RAKWireless/RAK2270-Sticker-Tracker/Hardware/RAK2270-bareboard-1.jpg

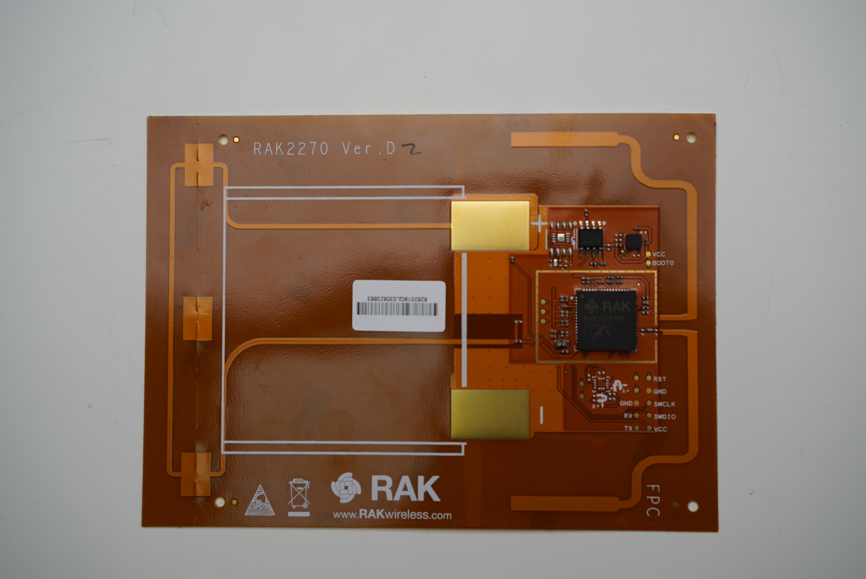
Hardware/RAK2270-bareboard-1.jpg
