RAKWireless/RAK2270-Sticker-Tracker/Hardware/pins_location.png

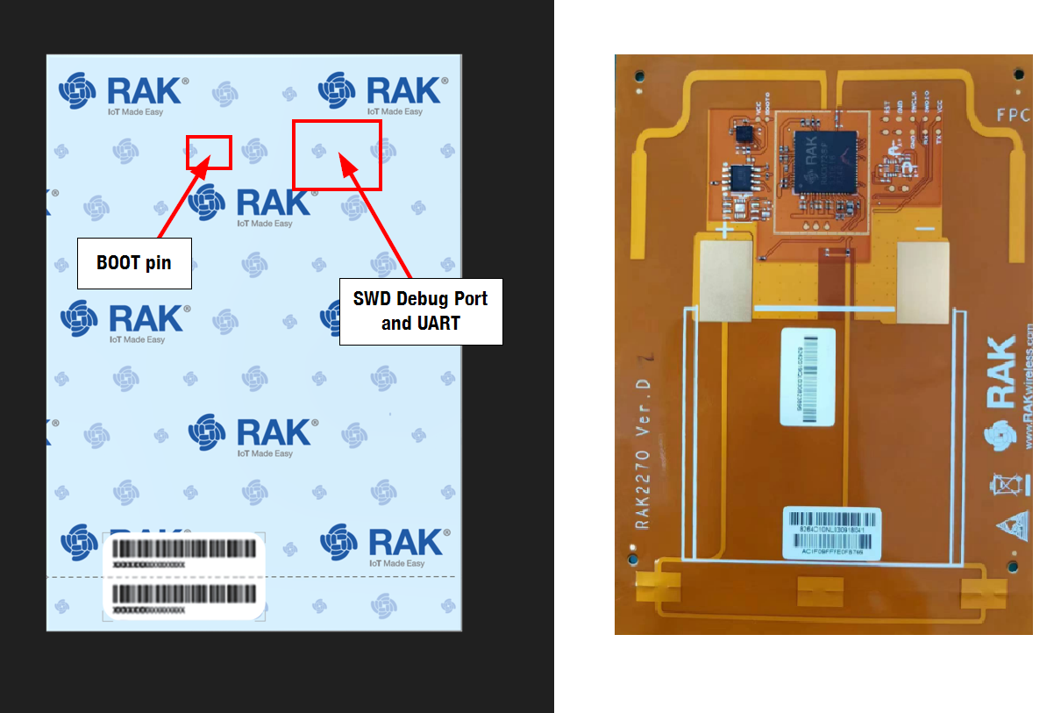
Hardware/pins_location.png
