RAKWireless/RAK2270-Sticker-Tracker/Hardware/RAK2270-sticker-2.png

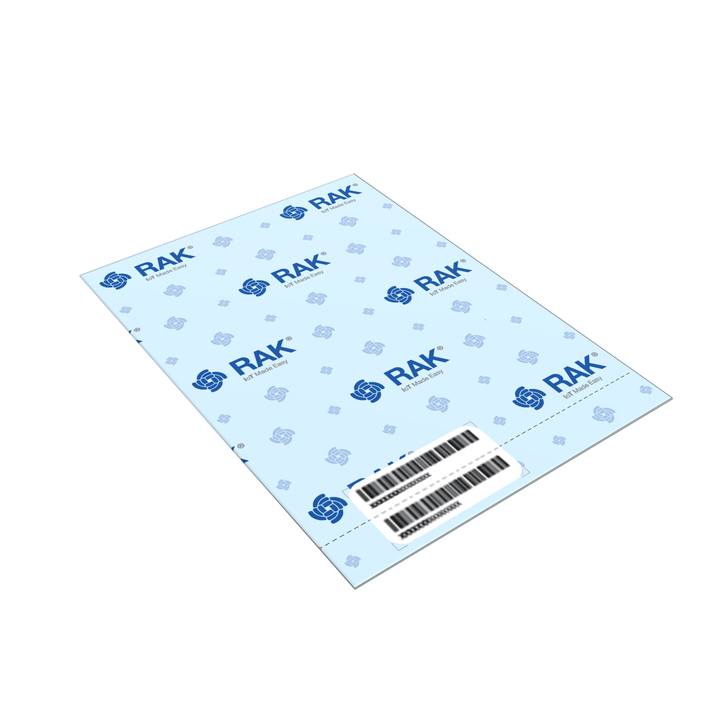
Hardware/RAK2270-sticker-2.png
