RAKWireless/RAK2270-Sticker-Tracker/Hardware/BOM of RAK2270(FPCB-WITHOUT EEPROM-OPENSOURCE).xls

RAK code | Quantity | Manufacturer | Part number | Description | Designator
0807A01A | 2 | YAGEO , 国巨股份有限公司 | CC0402MRX5R5BB475 | Capacitor-6.3V-4.7uF-±20%-X5R-0402 | C1,C7
08070009 | 8 | YAGEO , 国巨股份有限公司 | CC0402KRX5R9BB104 | Capacitor-50V-100nF-±10%-X5R-0402 | C2,C3,C8,C10,C11,C12,C16,C23
08070612 | 4 | MURATA , 村田制作所 | GRM155R61A105KE15D | Capacitor-10V-1uF-±10%-X5R-0402 | C4,C5,C6,C9
0807C001 | 1 | YAGEO , 国巨股份有限公司 | CC0402KRX5R9BB474 | Capacitor-50V-470nF-±10%-X5R-0402 | C15
08070561 | 2 | TDK , 东京电气化学株式会社 | C1005X5R1A104KT000F | Capacitor-10V-100nF-±10%-X5R -0402 | C17,C18
0807C002 | 1 | MURATA , 村田制作所 | GRM1555C1H560JA01D | Capacitor-50V-56pF-±5%-COG-0402 | C19
1007B006 | 3 | MURATA , 村田制作所 | BLM15PD121SN1B | EMI Ferrite Bead-120Ω-±25%@100MHz-0.09Ω-1.3A-0402 | E1,E2,E3
1003C00V | 1 | TDK , 东京电气化学株式会社 | MLZ2012M150WT000 | Inductor-15uH-±20%-0.95Ω±30%-250mA-0805 | L1
07090867 | 7 | YAGEO , 国巨股份有限公司 | RC0402FR-0710KL | Resistor-1/16W-10KΩ-±1％-0402 | R1,R2,R11,R15,R16,R23,R24
0705B001 | 1 | MURATA , 村田制作所 | NCP15XH103F03RC | NTC Thermistor-10KΩ ±1％-B(25-50℃) 3380K-0402 | R10
07090809 | 1 | YAGEO , 国巨股份有限公司 | RC0402JR-071KL | Resistor-1/16W-1KΩ-±5%-0402 | R25
4204C011 | 1 | RAK | RAK3172-SIP | IC MCU-RAK3172-SiP-32 bit Cortex M4-LoRa Transceiver-256KB Flash-64KB SRAM-QFN64-12*12mm | U1
07090793 | 2 | YAGEO , 国巨股份有限公司 | RC0402JR-074K7L | Resistor-1/16W-4.7KΩ-±5％-0402 | R20,R21
3301C002 | 1 | ST MICROELECTRONICS,意法半导体 | LIS3DH | Sensor-MEMS-Motion sensor-1.71~3.6V-LGA16-3*3*1mm | U2
8261010Y | 1 |  |  | FPCB-WisNode-Stick Sensor-RAK2270-2 Layer-Thickness 0.2mm-2x2 Panel-Panel Size 198*238mm-PCB Size 85*118mm
