RAKWireless/RAK2270-Sticker-Tracker/(threads)

Thread 3 (2023-11-07):

Arduino New IDE 2.x not finding Installation JSON

hpssjellis, 2023-11-07:
The new Arduino 2.x IDE is having troubles finding the installation STM32 boards. It loads the other RAKWireless boards but not the RUI ones. It seems to load the .JSON file fine but when we search for "RAK" it does not find the ```RAKwireless RUI STM32``` Boards. I am find since I can use the old Arduino IDE, just wondering if the new Arduino IDE works for anyone else.

```
https://raw.githubusercontent.com/RAKWireless/RAKwireless-Arduino-BSP-Index/main/package_rakwireless.com_rui_index.json
```

The Old Arduino IDE 1.8.x works fine, just search for ```RAK``` and the boards are found

carlrakwireless, 2023-11-08:
Hi @hpssjellis ,

It my setup, I see the RAK RUI3 based modules.

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

I do not use Arduino 2.x though as a still find legacy Arduino IDE faster/leaner to use.

hpssjellis, 2023-11-08:
Hey @carlrakwireless. Good to know it does works for someone. I have tried 3 Arduino IDE v2 with no luck even though the other RAKwireless .json file works fine.  I do have the old Arduino IDE on some of my computers so I should be fine. I will tag you on a few more issues. We can close this one.

Closed 2023-11-08.

Thread 4 (2023-11-08):

Which board is compatible to the RAK2270 is it WisDuo RAK3172 E or T

hpssjellis, 2023-11-08:
**Which board is compatible to the RAK2270 is it WisDuo RAK3172 E or T**

@carlrakwireless  Is the compatible board the WisDuo  RAK3172 Evaluation board or the WisDuo RAK3172 T Board

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

carlrakwireless, 2023-11-08:
It should be `WisDuo RAK3172-T Board`.

hpssjellis, 2023-11-08:
> It should be `WisDuo RAK3172-SiP Board`.

I agree, but that isn't one of the options in the image. The image shows the WisDuo RACK3**2**72-SiP board.

```
The main chip used on the RAK2270 is the WisDuo Module RAK3172-SiP/RAK3172LP-SiP (pin-to-pin and software compatible). This chip has STM32WL SoC which is a combination of MCU and LoRa/SubGhz transceiver. The firmware written on this is based on [RUI3](https://docs.rakwireless.com/RUI3/). You can start creating your own firmware using this [RAK3172-SiP guide](https://docs.rakwireless.com/Product-Categories/WisDuo/RAK3172-SiP/Quickstart/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).
```

carlrakwireless, 2023-11-08:
I see. You can choose `RAK3272-SiP Board`. It will work fine.

hpssjellis, 2023-11-08:
Sounds, good thanks.

Closed 2023-11-08.

Thread 5 (2023-11-08):

Example Acceleration code for the RAK2270

hpssjellis, 2023-11-08:
**Example Acceleration code for the RAK2270**

@carlrakwireless

Where would I find example Acceleration code for the RAK2270?

It looks like it is fairly simple I2C communication

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

carlrakwireless, 2023-11-08:
Hi @hpssjellis ,

The 3-axis accelerometer is based on RAK1904.

You can follow this guide for its basic functionality.

https://docs.rakwireless.com/Product-Categories/WisBlock/RAK1904/Quickstart/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

Closed 2023-11-08.

Thread 6 (2023-11-22):

Generic RAK2270 Firmware

hpssjellis, 2023-11-22:
Any chance a generic RAK2270 firmware with version number could be posted.

@carlrakwireless

It would be really interesting to see what compression method is used, how it is done and if the present firmware has any download read ability (To perhaps change the data upload rate etc.). Also to see how the temperature value is read and if the accelerometer is initiated (Probably not)

carlrakwireless, 2023-11-22:
I already replied in RAK forum. Closing.

Closed 2023-11-22.
