RAKWireless/RAK2270-Sticker-Tracker/Hardware/Schematic_RAK2270_VC_2023_0530.pdf

# Debug Interface

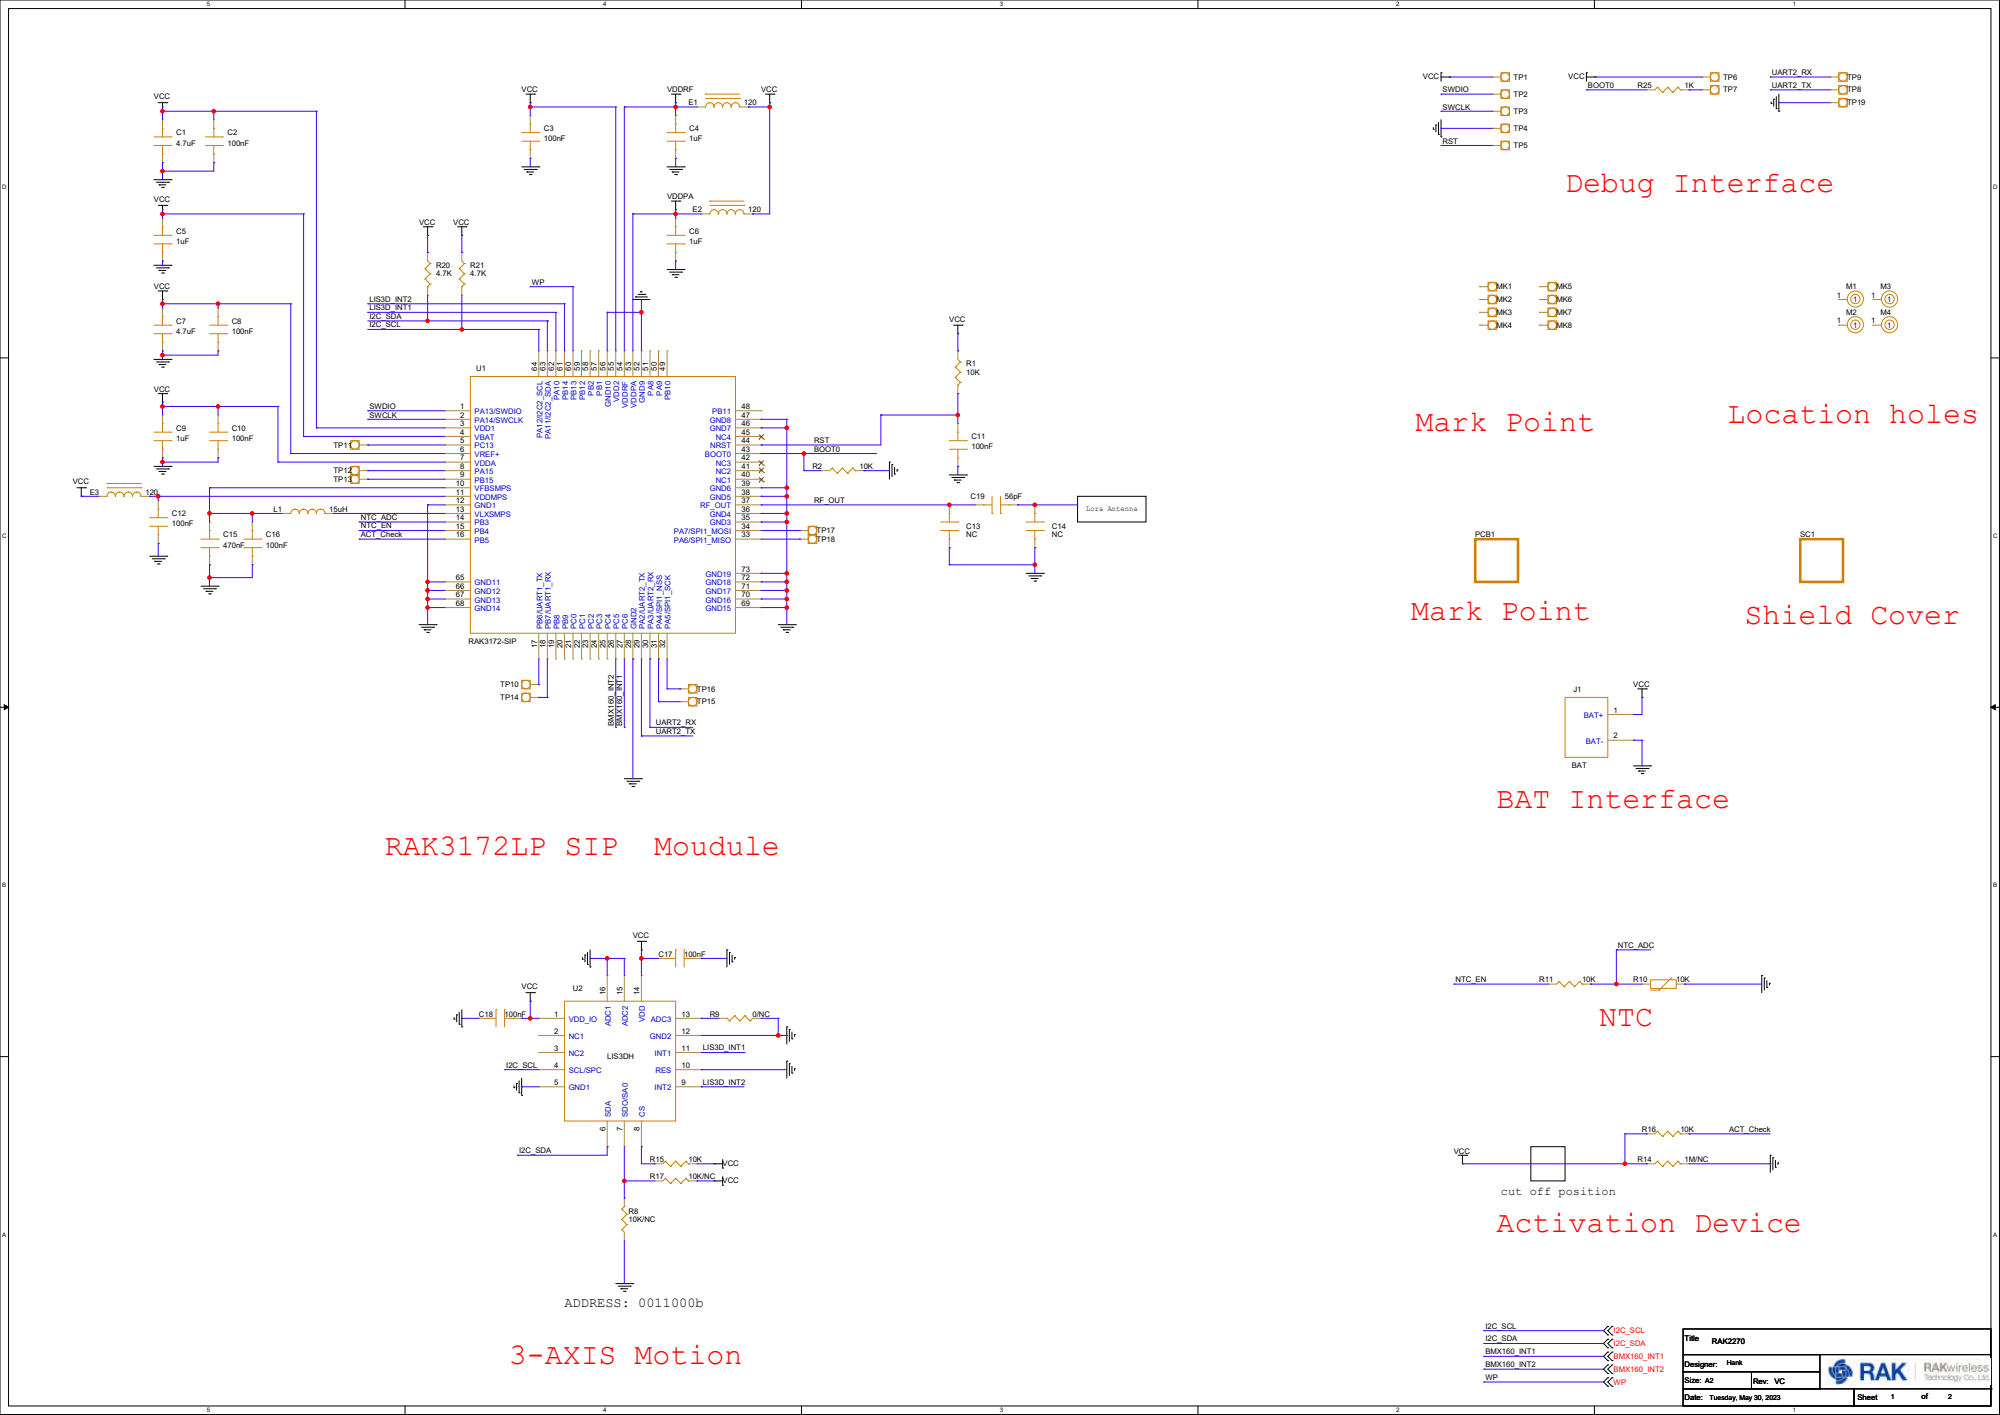
[picture p6: page 1]

SOIC-8 | ADDRESS: 1110000

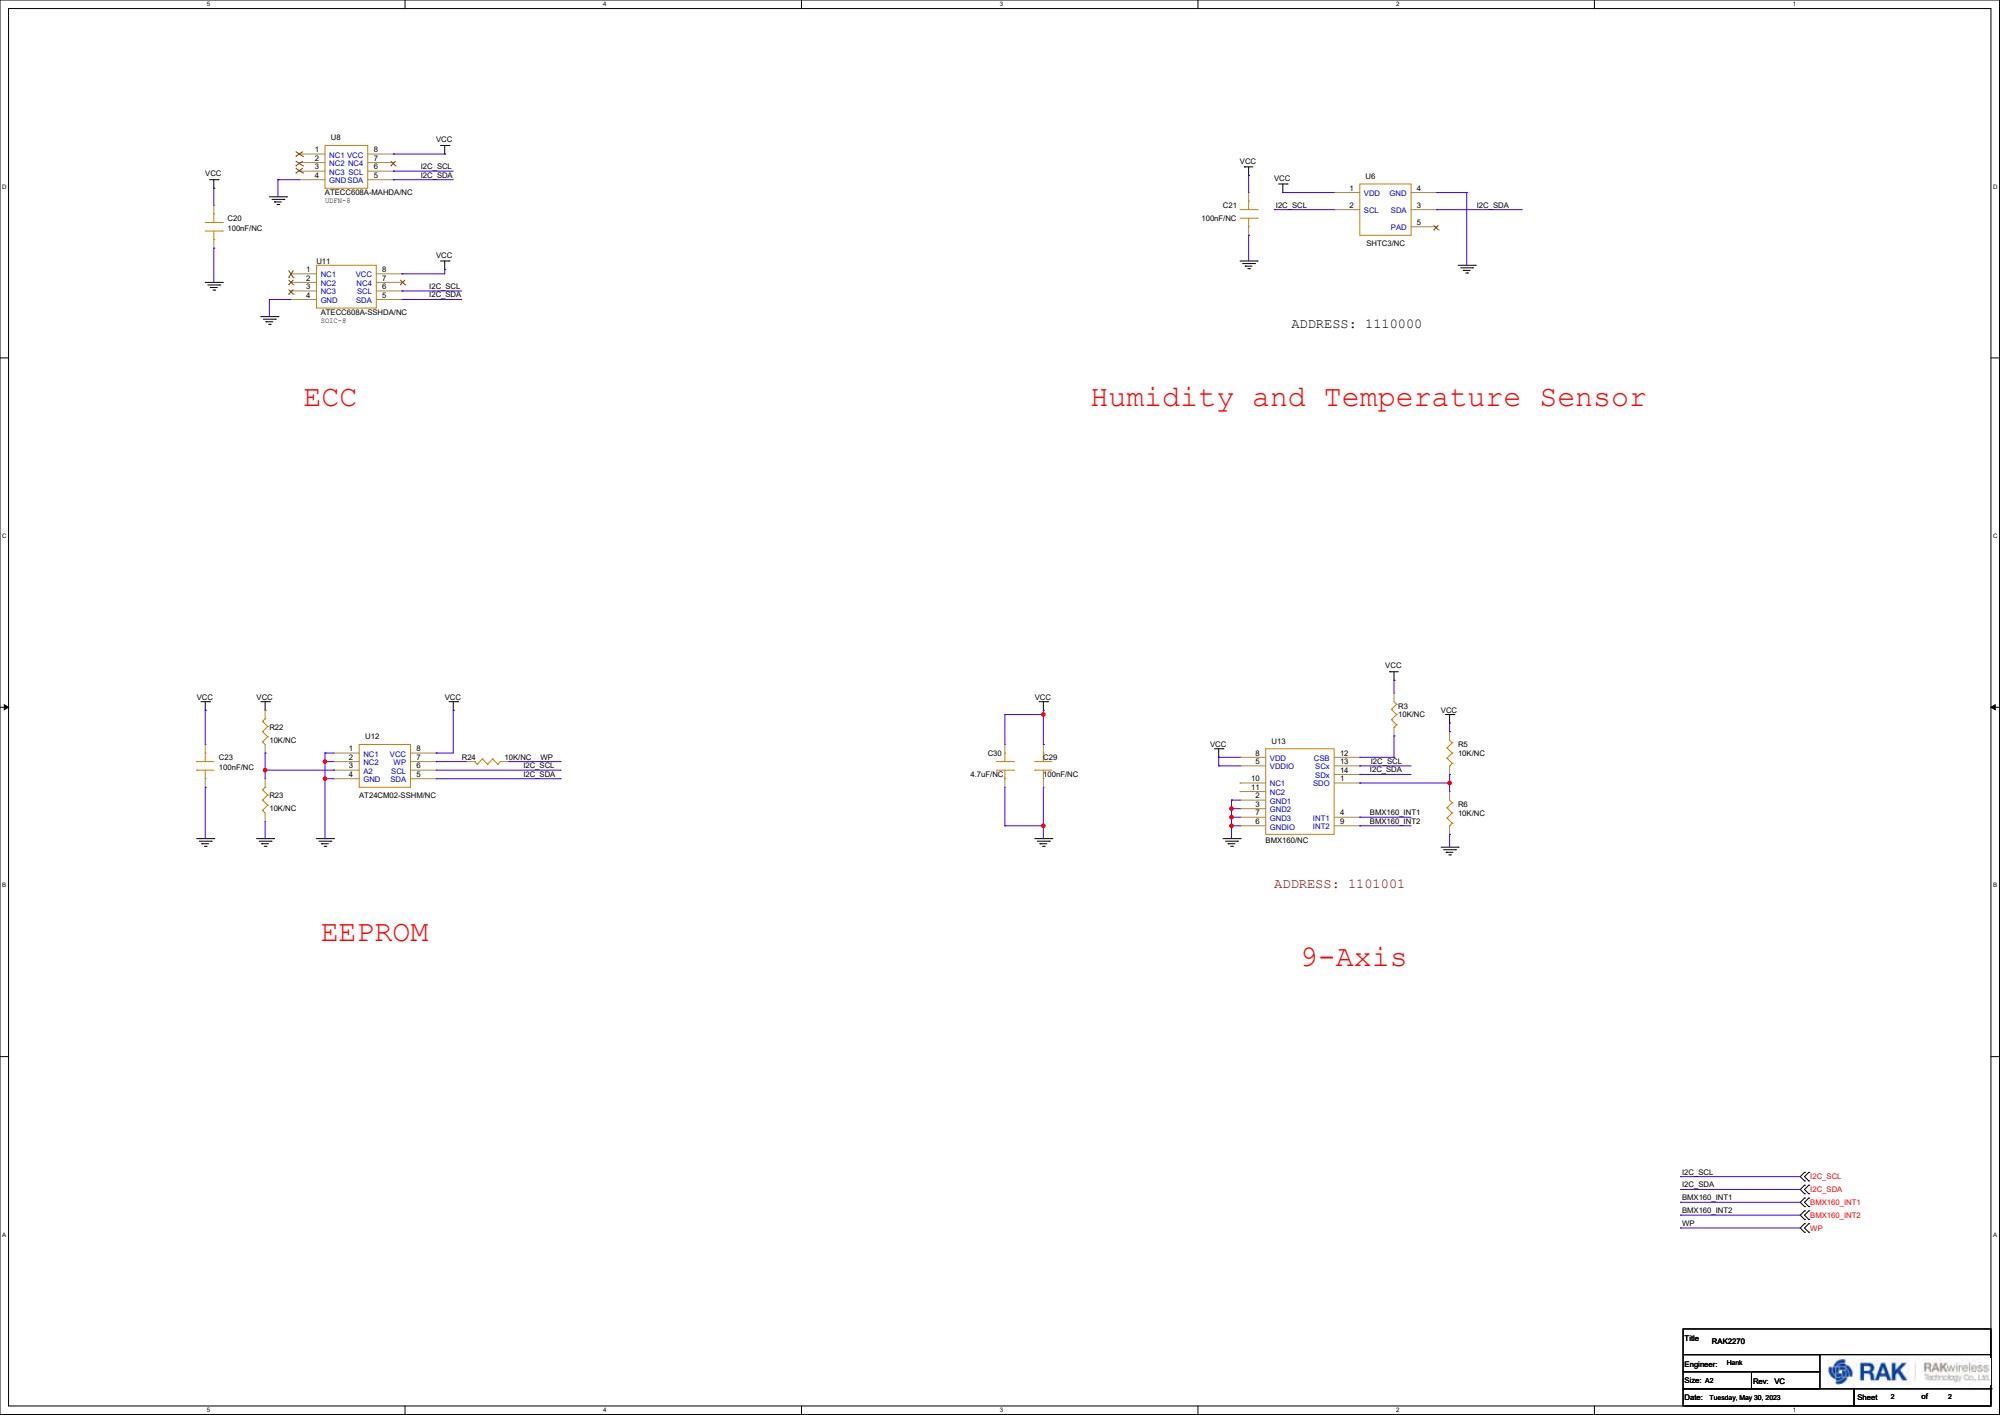
[picture p7: page 2]

Humidity and Temperature Sensor
