RAKWireless/RAK2270-Sticker-Tracker/Hardware/Testpoints_RAK2270_FPC_VC.pdf

# ART FILM - adt

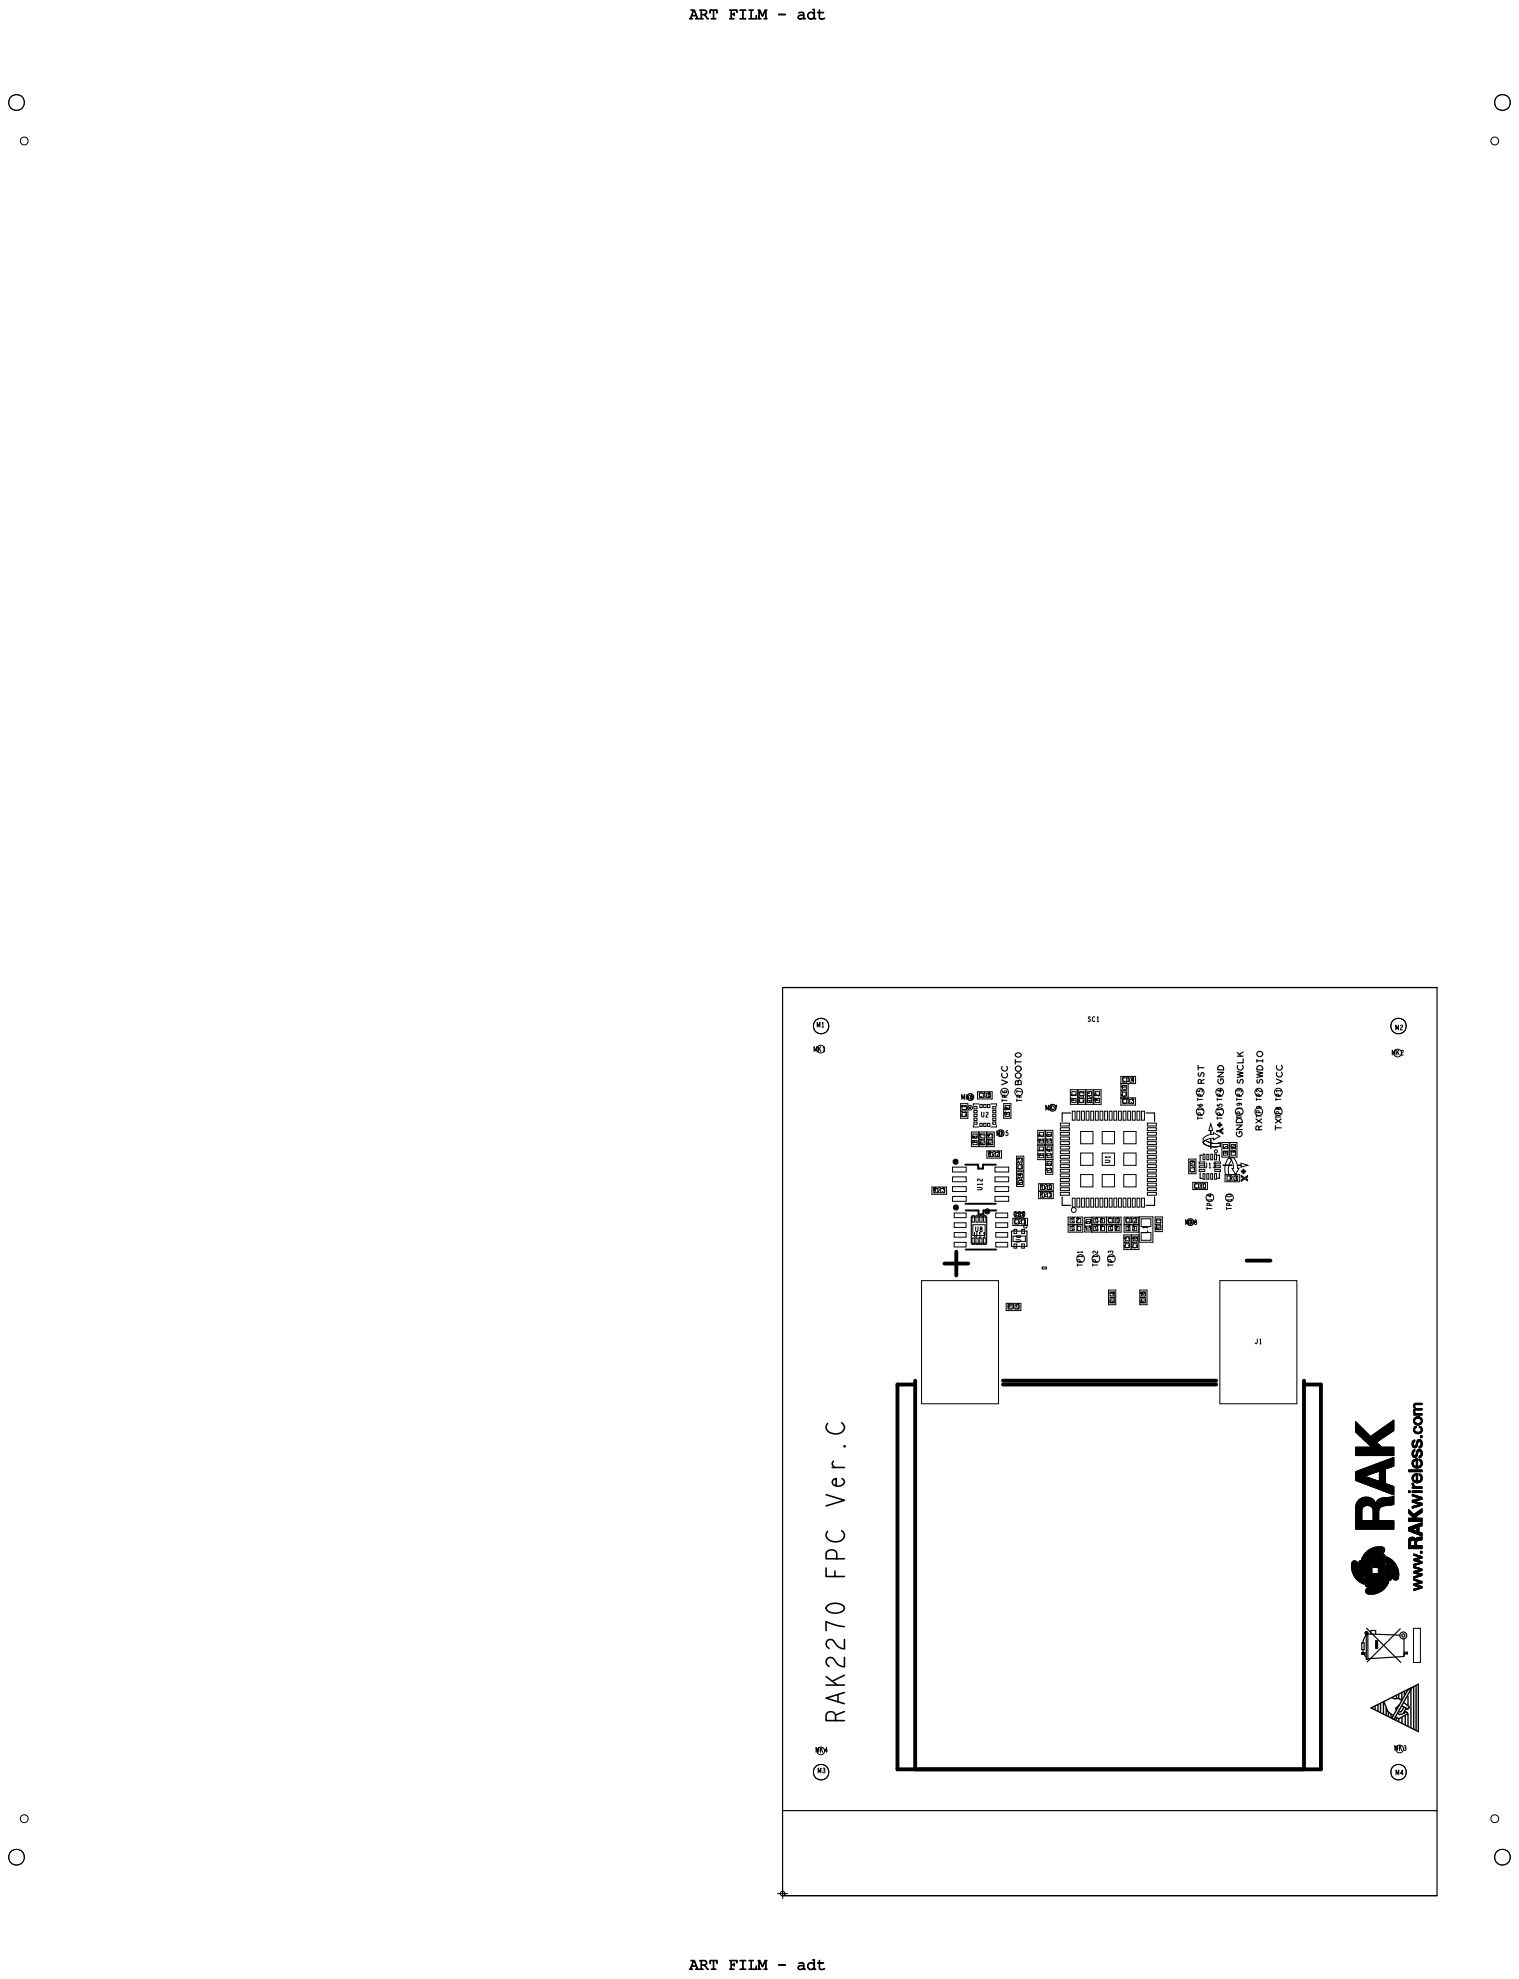
[picture p8: page 1]

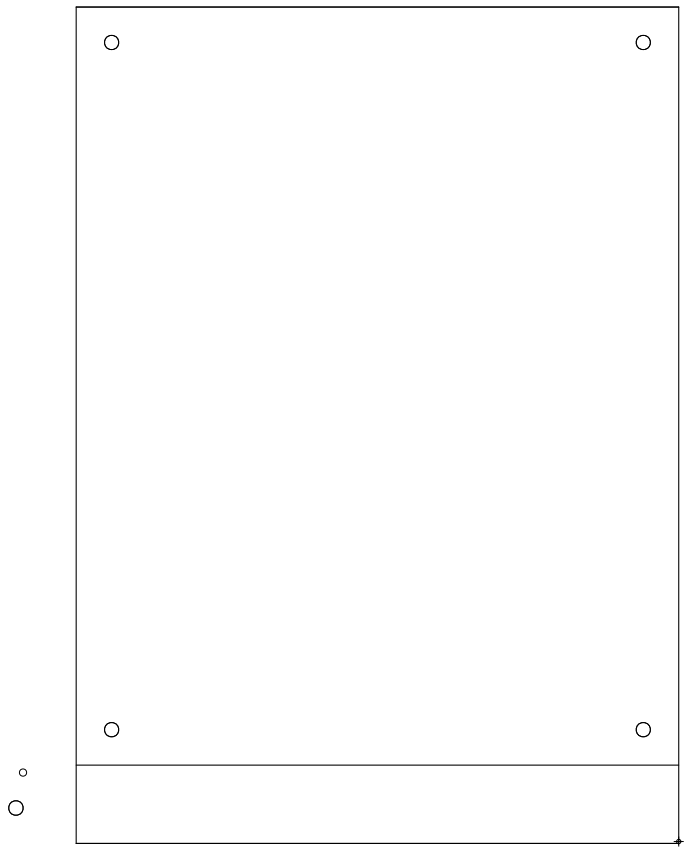
[picture p9: figure]

# ART FILM - adb

# ART FILM - adb
