RAKWireless/RAK2270-Sticker-Tracker/(list of files, drawings)

Other design files:
Hardware/Cadence/RAK2270_VC_2023_0531.DSN
