RAKWireless/RAK2270-Sticker-Tracker/(commit log)

2023-09-20 added hardware files
    [RAK2270_VC_2023_0531.DSN]
2023-11-03 added spreadsheet of battery life estimate calculation
    [RAK2270 Estimate Battery Life V1.xlsx]
2023-11-21 added bom and placement files
    [BOM of RAK2270(FPCB-WITHOUT EEPROM-OPENSOURCE).xls]
